farhanqaisarlink/farlink-netedge-/Hardware/Manufacturing Files/BOM/Network Analyzer.xlsx

Item | Reference | Qty | Value | Footprint | Manufacturer Part | Description | Note
1 | BOOT1 | 1 | Conn_01x02_Pin | Connector_PinHeader_2.54mm:PinHeader_1x02_P2.54mm_Vertical |  | Generic connector, single row, 01x02, script generated
2 | C1 | 1 | 100n/50V | Capacitor_SMD:C_0603_1608Metric |  | CAP CER 0.1UF 50V X7R 0603
3 | C2,C4,C5,C6 | 4 | 10uF/10V | Capacitor_SMD:C_0603_1608Metric |  | CAP CER 10UF 50V X5R 0805
4 | C3 | 1 | 100uF/10V | Capacitor_SMD:C_1210_3225Metric | GRM21BR61H106KE43L | CAP CER 10UF 50V X5R 0805
5 | C7,C9 | 2 | 10uf/10V | Capacitor_SMD:C_0603_1608Metric_Pad1.08x0.95mm_HandSolder
6 | C8 | 1 | 100nF/10V | Capacitor_SMD:C_0603_1608Metric_Pad1.08x0.95mm_HandSolder
7 | C10 | 1 | 10uF/10V | Capacitor_SMD:C_0603_1608Metric_Pad1.08x0.95mm_HandSolder |  | 10uF/16V
8 | C11 | 1 | 100nF/10V | Capacitor_SMD:C_0603_1608Metric
9 | CONSOLE1 | 1 | Conn_01x03_Pin | Connector_PinHeader_2.54mm:PinHeader_1x03_P2.54mm_Vertical |  | Generic connector, single row, 01x03, script generated
10 | D1,D2 | 2 | SMBJ5_0A_C83333 | JLCImport:SMBJ5_0A_C83333 | SMBJ5_0A_C83333 | -65℃~+150℃ 5V 6.4V 600W 65.3A 65.3uA 9.2V IEC 61000-4-2、IEC 61000-4-4 TVS Unidirectional DO-214AA ESD and Surge Protection (TVS/ESD) ROHS
11 | ETH1 | 1 | ARJM11D7-502-AB-EW2 | ARJM11D7-502-AB-EW2:ABRACON_ARJM11D7-502-AB-EW2 | ARJM11D7-502-AB-EW2 | 1 Port RJ45 Magjack Connector Through Hole 10/100/1000 Base-T, AutoMDIX
12 | LED_PWR1 | 1 | LTST-S270KGKT | JLCImport:LTST-S270KGKT | LTST-S270KGKT | -30℃~+85℃ 130° 20mA 2V 571nm 574nm 71mcd 75mW Discrete Diode Side View Mount Water Clear Yellow Green SMD,1.6x1.2mm LED Indication - Discrete ROHS
13 | LED_STATUS1 | 1 | LTST-S270KRKT | JLCImport:LTST-S270KRKT | LTST-S270KRKT | -30℃~+85℃ 130° 20mA 2V 571nm 574nm 71mcd 75mW Discrete Diode Side View Mount Water Clear Yellow Green SMD,1.6x1.2mm LED Indication - Discrete ROHS
14 | Module1 | 2 | ComputeModule5-CM5 | CM5IO:Raspberry-Pi-5-Compute-Module | DF40C-100DS-0.4V(51) | 100 Position Connector Receptacle, Center Strip Contacts Surface Mount Gold | Install 2 × DF40C-100DS-0.4V(51) connectors for CM5
15 | PWR_SW1 | 1 | PB400OAQR1BLK | PB400OAQR1BLK:SW_PB400OAQR1BLK | PB400EEQR1BLK | Pushbutton Switch DPST Standard Through Hole, Right Angle
16 | R1,R2 | 2 | 470 Ohm | Resistor_SMD:R_0603_1608Metric
17 | R3 | 1 | 15kOhm | Resistor_SMD:R_0603_1608Metric
18 | R4 | 1 | 2.2k | Resistor_SMD:R_0603_1608Metric_Pad0.98x0.95mm_HandSolder |  | Resistor, US symbol
19 | R5,R9 | 2 | 10k | Resistor_SMD:R_0603_1608Metric_Pad0.98x0.95mm_HandSolder |  | Resistor, US symbol
20 | R6 | 1 | 1k | Resistor_SMD:R_0603_1608Metric |  | Resistor, US symbol
21 | R7 | 1 | 100 | Resistor_SMD:R_0603_1608Metric |  | Resistor, US symbol
22 | R8,R13 | 2 | 10 | Resistor_SMD:R_0603_1608Metric |  | Resistor, US symbol
23 | R10,R12 | 2 | 10k | Resistor_SMD:R_0603_1608Metric |  | Resistor, US symbol
24 | R11 | 1 | 1kOhm | Resistor_SMD:R_0603_1608Metric |  | Resistor, US symbol
25 | SDCARD1 | 1 | 1040310811 | JLCImport:1040310811 | 1040310811 | -25℃~+85℃ 1.42mm Connector and Ejector MicroSD Card (TF Card) Push-Pull SMD SD Card / Memory Card Connector ROHS
26 | SW1 | 1 | 1825027-5 | JLCImport:1825027-5 | 1825027-5 | -20℃~+105℃ 1.24mm 1.6N 24V 3.5mm 50mA 7mm PC Pin Right Angle Round Button SPST 弯插,7x3.5mm Tactile Switches ROHS
27 | TEST_SW1 | 1 | B2B-PH-K-S_LF_SN | JLCImport:B2B-PH-K-S_LF_SN | B2B-PH-K-S(LF)(SN) | -25℃~+85℃ 1 100V 1x2P 2 2A 2P 2mm 4.5mm 5.9mm 6mm Brass K Pin PA66 PH Through Hole Tin UL94V-0 White 插件,P=2mm Wire To Board Connector ROHS
28 | U1,U2 | 2 | TPD4EUSB30 | Package_SON:USON-10_2.5x1.0mm_P0.5mm | TPD4EUSB30DQAR
29 | U3 | 1 | DS1021-2X13SF11-B | JLCImport:DS1021-2X13SF11-B | DS1021-2x13SF11-B | -40℃~+105℃ 2 2.54mm 2.54mm 250V 26P 2x13P 3A Black Copper alloy Gold Pin Header Through Hole Plugin,P=2.54mm Pin Headers ROHS
30 | U4 | 1 | AP22653W6-7 | Package_TO_SOT_SMD:SOT-23-6 | AP22653W6-7 | LOAD SWITCH,SOT26,T&R,3K
31 | U5 | 1 | TPS22998RYZR | JLCImport:TPS22998RYZR | TPS22998RYZR | -40℃~+105℃ 1 10A 200mV~5.5V 4mΩ Active High Load Switch Output discharge function、Soft-start、Over temperature protection WQFN-HR-10 Power Distribution Switches ROHS
32 | U6 | 1 | MY-1220-03-R | JLCImport:MY-1220-03-R | MY-1220-03-R | Battery buckle CR1220 Nickel plated Phosphor bronze - ROHS
33 | U7,U8 | 2 | 74LVC1G07GW_125 | 74LVC1G07GW_125:IC_74LVC1G07GW_125 | 74LVC1G07GW_125 | Buffer, Non-Inverting 1 Element 1 Bit per Element Open Drain Output 5-TSSOP
34 | U9 | 1 | RT9742GGJ5 | JLCImport:RT9742GGJ5 | RT9742GGJ5 | -40℃~+85℃ 1 1A 2.7V~6V 70mΩ Active High High Side Switch Short-Circuit Protection(SCP)、Undervoltage Protection(UVP)、Overcurrent Protection(OCP)、Over Temperature Protection TSOT-23-5 Power Distribution Switches ROHS
35 | U10,U11,U12 | 3 | USBLC6-2SC6 | USBLC6-2SC6:SOT95P280X145-6N | USBLC6-2SC6 | 17V Clamp 5A (8/20µs) Ipp Tvs Diode Surface Mount SOT-23-6
36 | USB1 | 1 | GSB4111312HR | JLCImport:GSB4111312HR | GSB4111312HR | 1 9P Blue Female Right Angle Type-A USB 3.1 插件 USB Connectors ROHS
37 | USB_BOOT1 | 1 | USB4120-03-C | JLCImport:USB4120-03-C | USB4120-03-C | -25℃~+85℃ 1 24P 48V 5A Black Female Type-C USB 2.0 SMD USB Connectors ROHS
38 | USB_POWER1 | 1 | USB4215-03-A_REVA | USB4215-03-A_REVA:GCT_USB4215-03-A_REVA | USB4215-03-A | USB-C (USB TYPE-C) USB 2.0 Receptacle Connector 24 (16+8 Dummy) Position Surface Mount, Right Angle; Through Hole
