farhanqaisarlink/farlink-netedge-/Hardware/PCBWAY/T-X52W642709A-2units-Network+Analyzer(2026-08-12).xls

PCBWay Bom Quotation, Product No.:T-X52W642709A
Item # | *Designator | *Qty | *Mfg Part # | Description / Value | *Package/Footprint | Your Instructions / Notes | *Unit Price(2 units) | *Total | *Delivery Time | *Actual Purchase Mfg Part # | *PCBWay Note | Customer Reply | PCBWay Update
1 | BOOT1 | 1 | Conn_01x02_Pin | Generic connector, single row, 01x02, script generated | Connector_PinHeader_2.54mm:PinHeader_1x02_P2.54mm_Vertical |  | $0.065 | $0.130 |  | PZ254V-11-02P | we will supply is PZ254V-11-02P ,OK?pls confirm
2 | C1 | 1 | 100n/50V | CAP CER 0.1UF 50V X7R 0603 | Capacitor_SMD:C_0603_1608Metric |  | $0.146 | $0.292 |  | CC0603KRX7R9BB104
3 | C2,C4,C5,C6 | 4 | 10uF/10V | CAP CER 10UF 50V X5R 0805 | Capacitor_SMD:C_0603_1608Metric |  | $0.116 | $0.928 |  | CL10A106KP8NNNC | Package should be 0603 or 0805？
4 | C3 | 1 | 100uF/10V | CAP CER 10UF 50V X5R 0805 | Capacitor_SMD:C_1210_3225Metric |  | $1.006 | $2.012 |  | GRM21BR61H106KE43L | The correct package for the listed Part Number [GRM21BR61H106KE43L] is indeed [0805], not [1210].Please confirm.
5 | C7,C9 | 2 | 10uf/10V |  | Capacitor_SMD:C_0603_1608Metric_Pad1.08x0.95mm_HandSolder |  | $0.194 | $0.776 |  | CL10A106KP8NNNC | The correct package for the listed Part Number [10uF/10V] is indeed [CP_EIA-3216-18_Kemet-A], not [0603].Please confirm.
6 | C8 | 1 | 100nF/10V |  | Capacitor_SMD:C_0603_1608Metric_Pad1.08x0.95mm_HandSolder |  | $0.652 | $1.304 |  | 0603ZD104KAT2A
7 | C10 | 1 | 10uF/10V | 10uF/16V | Capacitor_SMD:C_0603_1608Metric_Pad1.08x0.95mm_HandSolder |  | $0.387 | $0.774 |  | CL10A106KP8NNNC | The correct package for the listed Part Number [10uF/10V] is indeed [CP_EIA-3216-18_Kemet-A], not [0603],The correct voltage for the listed Part Number [10uF/10V] is indeed [10V], not [16V].Please confirm.
8 | C11 | 1 | 100nF/10V |  | Capacitor_SMD:C_0603_1608Metric |  | $0.652 | $1.304 |  | 0603ZD104KAT2A
9 | CONSOLE1 | 1 | Conn_01x03_Pin | Generic connector, single row, 01x03, script generated | Connector_PinHeader_2.54mm:PinHeader_1x03_P2.54mm_Vertical |  | $0.075 | $0.150 |  | PZ254V-11-03P | we will supply is PZ254V-11-03P,OK?pls confirm
10 | D1,D2 | 2 | SMBJ5_0A_C83333 | -65℃~+150℃ 5V 6.4V 600W 65.3A 65.3uA 9.2V IEC 61000-4-2、IEC 61000-4-4 TVS Unidirectional DO-214AA ESD and Surge Protection (TVS/ESD) ROHS | JLCImport:SMBJ5_0A_C83333 |  | $0.165 | $0.660 |  | SMBJ5.0A
11 | ETH1 | 1 | ARJM11D7-502-AB-EW2 | 1 Port RJ45 Magjack Connector Through Hole 10/100/1000 Base-T, AutoMDIX | ARJM11D7-502-AB-EW2:ABRACON_ARJM11D7-502-AB-EW2 |  | $7.369 | $14.738 |  | ARJM11D7-502-AB-EW2
12 | LED_PWR1 | 1 | LTST-S270KGKT | -30℃~+85℃ 130° 20mA 2V 571nm 574nm 71mcd 75mW Discrete Diode Side View Mount Water Clear Yellow Green SMD,1.6x1.2mm LED Indication - Discrete ROHS | JLCImport:LTST-S270KGKT |  | $0.077 | $0.154 |  | LTST-S270KGKT
13 | LED_STATUS1 | 1 | LTST-S270KRKT | -30℃~+85℃ 130° 20mA 2V 571nm 574nm 71mcd 75mW Discrete Diode Side View Mount Water Clear Yellow Green SMD,1.6x1.2mm LED Indication - Discrete ROHS | JLCImport:LTST-S270KRKT |  | $0.099 | $0.198 |  | LTST-S270KRKT
14 | Module1 | 2 | ComputeModule5-CM5 | 100 Position Connector Receptacle, Center Strip Contacts Surface Mount Gold | CM5IO:Raspberry-Pi-5-Compute-Module | Install 2 × DF40C-100DS-0.4V(51) connectors for CM5 | $1.610 | $6.440 |  | DF40C-100DS-0.4V(51)
15 | PWR_SW1 | 1 | PB400OAQR1BLK | PUSHBUTTON, 3A, 30VDC DPST, Off-(On), Through Hole, Right Angle | PB400OAQR1BLK:SW_PB400OAQR1BLK |  | $3.463 | $6.926 |  | PB400OAQR1BLK
16 | R1,R2 | 2 | 470 Ohm |  | Resistor_SMD:R_0603_1608Metric |  | $0.024 | $0.096 |  | 0603WAF4700T5E
17 | R3 | 1 | 15kOhm |  | Resistor_SMD:R_0603_1608Metric |  | $0.063 | $0.126 |  | 0603WAF1502T5E
18 | R4 | 1 | 2.2k | Resistor, US symbol | Resistor_SMD:R_0603_1608Metric_Pad0.98x0.95mm_HandSolder |  | $0.040 | $0.080 |  | 0603WAF2201T5E
19 | R5,R9 | 2 | 10k | Resistor, US symbol | Resistor_SMD:R_0603_1608Metric_Pad0.98x0.95mm_HandSolder |  | $0.030 | $0.120 |  | NQ03WAF1002T5E
20 | R6 | 1 | 1k | Resistor, US symbol | Resistor_SMD:R_0603_1608Metric |  | $0.099 | $0.198 |  | RC0603FR-071KL
21 | R7 | 1 | 100 | Resistor, US symbol | Resistor_SMD:R_0603_1608Metric |  | $0.029 | $0.058 |  | 0603WAF1000T5E
22 | R8,R13 | 2 | 10 | Resistor, US symbol | Resistor_SMD:R_0603_1608Metric |  | $0.072 | $0.288 |  | AC0603FR-0710RL
23 | R10,R12 | 2 | 10k | Resistor, US symbol | Resistor_SMD:R_0603_1608Metric |  | $0.030 | $0.120 |  | NQ03WAF1002T5E
24 | R11 | 1 | 1kOhm | Resistor, US symbol | Resistor_SMD:R_0603_1608Metric |  | $0.099 | $0.198 |  | RC0603FR-071KL
25 | SDCARD1 | 1 | 1040310811 | -25℃~+85℃ 1.42mm Connector and Ejector MicroSD Card (TF Card) Push-Pull SMD SD Card / Memory Card Connector ROHS | JLCImport:1040310811 |  | $0.604 | $1.208 |  | 1040310811
26 | SW1 | 1 | 1825027-5 | -20℃~+105℃ 1.24mm 1.6N 24V 3.5mm 50mA 7mm PC Pin Right Angle Round Button SPST 弯插,7x3.5mm Tactile Switches ROHS | JLCImport:1825027-5 |  | $0.391 | $0.782 |  | 1825027-5
27 | TEST_SW1 | 1 | B2B-PH-K-S_LF_SN | -25℃~+85℃ 1 100V 1x2P 2 2A 2P 2mm 4.5mm 5.9mm 6mm Brass K Pin PA66 PH Through Hole Tin UL94V-0 White 插件,P=2mm Wire To Board Connector ROHS | JLCImport:B2B-PH-K-S_LF_SN |  | $0.458 | $0.916 |  | B2B-PH-K-S(LF)(SN)
28 | U1,U2 | 2 | TPD4EUSB30 |  | Package_SON:USON-10_2.5x1.0mm_P0.5mm |  | $0.528 | $2.112 |  | TPD4EUSB30DQAR | 品牌 TI(德州仪器) 封装 USON-10(1x2.5)
29 | U3 | 1 | DS1021-2X13SF11-B | -40℃~+105℃ 2 2.54mm 2.54mm 250V 26P 2x13P 3A Black Copper alloy Gold Pin Header Through Hole Plugin,P=2.54mm Pin Headers ROHS | JLCImport:DS1021-2X13SF11-B |  | $0.465 | $0.930 |  | DS1021-2x13SF11-B
30 | U4 | 1 | AP22653W6-7 | LOAD SWITCH,SOT26,T&R,3K | Package_TO_SOT_SMD:SOT-23-6 |  | $0.192 | $0.384 |  | AP22653W6-7
31 | U5 | 1 | TPS22998RYZR | -40℃~+105℃ 1 10A 200mV~5.5V 4mΩ Active High Load Switch Output discharge function、Soft-start、Over temperature protection WQFN-HR-10 Power Distribution Switches ROHS | JLCImport:TPS22998RYZR |  | $0.535 | $1.070 |  | TPS22998RYZR
32 | U6 | 1 | MY-1220-03-R | Battery buckle CR1220 Nickel plated Phosphor bronze - ROHS | JLCImport:MY-1220-03-R |  | $0.871 | $1.742 |  | MY-1220-03-R
33 | U7,U8 | 2 | 74LVC1G07GW_125 | Buffer, Non-Inverting 1 Element 1 Bit per Element Open Drain Output 5-TSSOP | 74LVC1G07GW_125:IC_74LVC1G07GW_125 |  | $0.187 | $0.748 |  | 74LVC1G07GW,125
34 | U9 | 1 | RT9742GGJ5 | -40℃~+85℃ 1 1A 2.7V~6V 70mΩ Active High High Side Switch Short-Circuit Protection(SCP)、Undervoltage Protection(UVP)、Overcurrent Protection(OCP)、Over Temperature Protection TSOT-23-5 Power Distribution Switches ROHS | JLCImport:RT9742GGJ5 |  | $0.108 | $0.216 |  | RT9742GGJ5
35 | U10,U11,U12 | 3 | USBLC6-2SC6 | 17V Clamp 5A (8/20µs) Ipp Tvs Diode Surface Mount SOT-23-6 | USBLC6-2SC6:SOT95P280X145-6N |  | $0.395 | $2.370 |  |  | ST(意法半导体) SOT-23-6L
36 | USB1 | 1 | GSB4111312HR | 1 9P Blue Female Right Angle Type-A USB 3.1 插件 USB Connectors ROHS | JLCImport:GSB4111312HR |  | $1.667 | $3.334 |  | GSB4111312HR
37 | USB_BOOT1 | 1 | USB4120-03-C | -25℃~+85℃ 1 24P 48V 5A Black Female Type-C USB 2.0 SMD USB Connectors ROHS | JLCImport:USB4120-03-C |  | $1.071 | $2.142 |  | USB4120-03-C
38 | USB_POWER1 | 1 | USB4215-03-A_REVA | USB-C (USB TYPE-C) USB 2.0 Receptacle Connector 24 (16+8 Dummy) Position Surface Mount, Right Angle; Through Hole | USB4215-03-A_REVA:GCT_USB4215-03-A_REVA |  | $0.828 | $1.656 | 7-10 Workdays | USB4215-03-A
 |  |  |  |  |  |  | Component Cost | $57.68
 |  |  |  |  |  |  | Assembly Cost
 |  |  |  |  |  |  | PCB Cost
 |  |  |  |  |  |  | V3 Member 3% off | $0.00
 |  |  |  |  |  |  | All Total 2 Units | $57.68
