farhanqaisarlink/farlink-netedge-/(list of files, cad)

Other CAD files:
Hardware/3D/with LCD.step
Hardware/3D/without LCD.step
