farhanqaisarlink/farlink-netedge-/Hardware/PDF/Network Analyzer.pdf

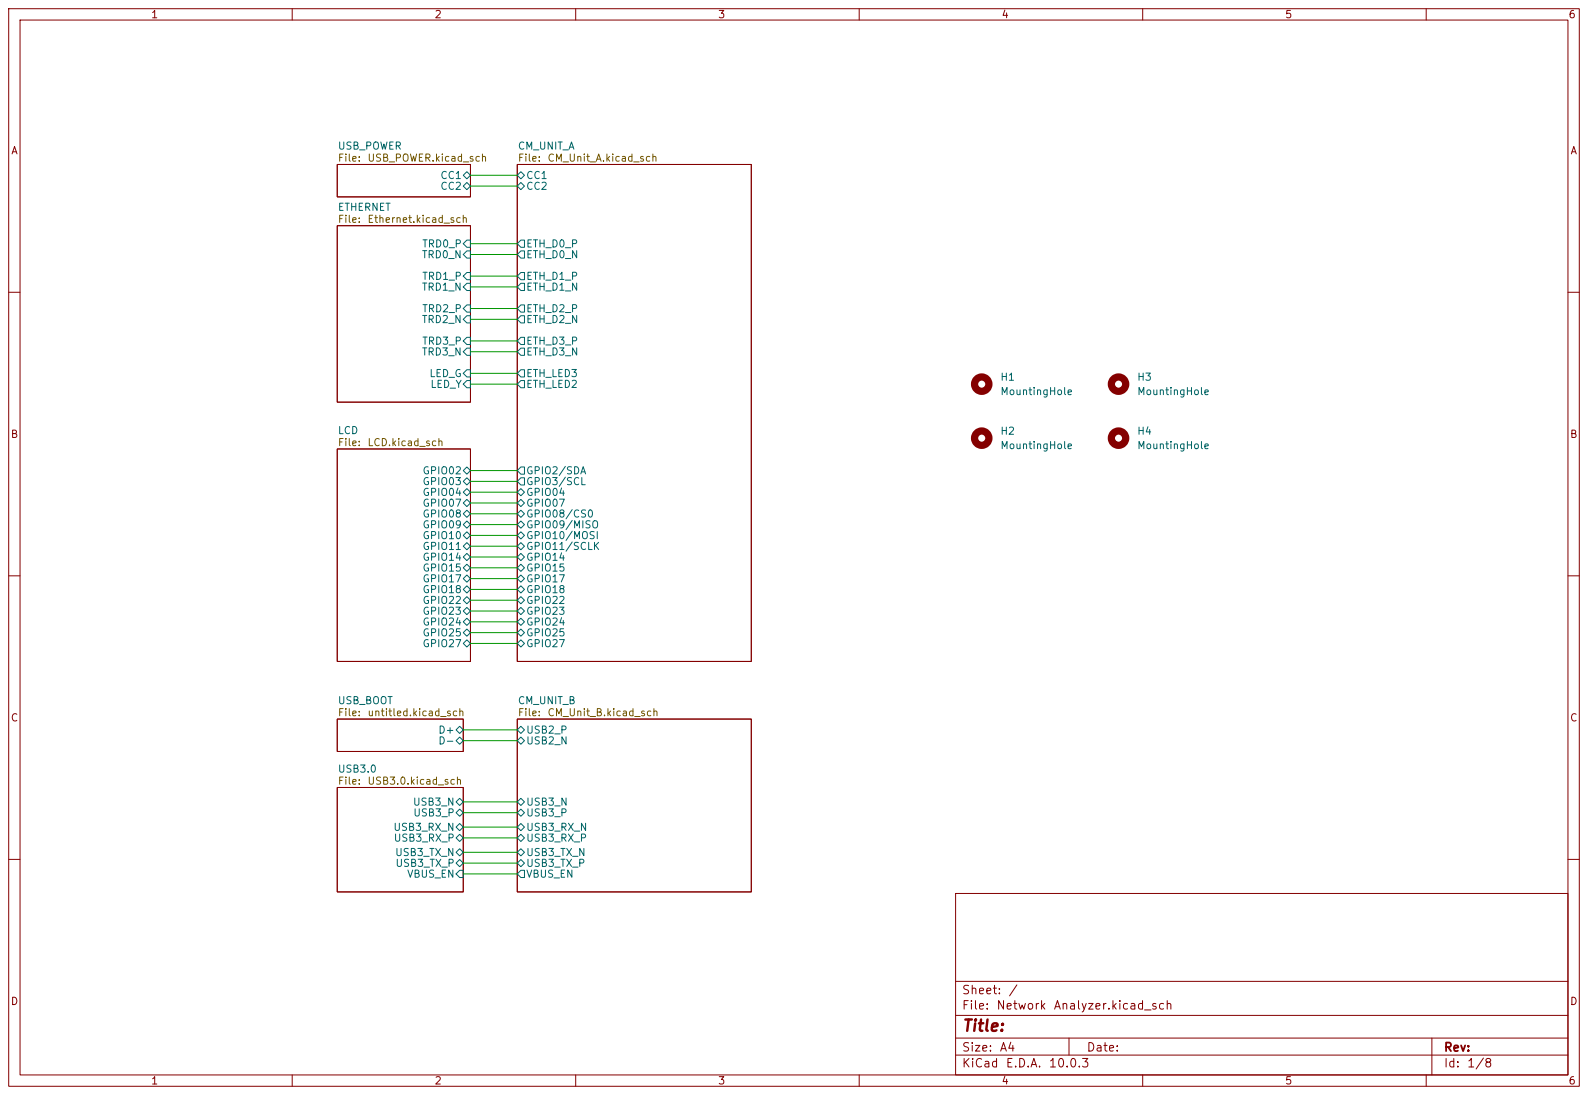
[picture p1: page 1]

Size: A4 | Rev:
KiCad E.D.A. 10.0.3 | Id: 1/8

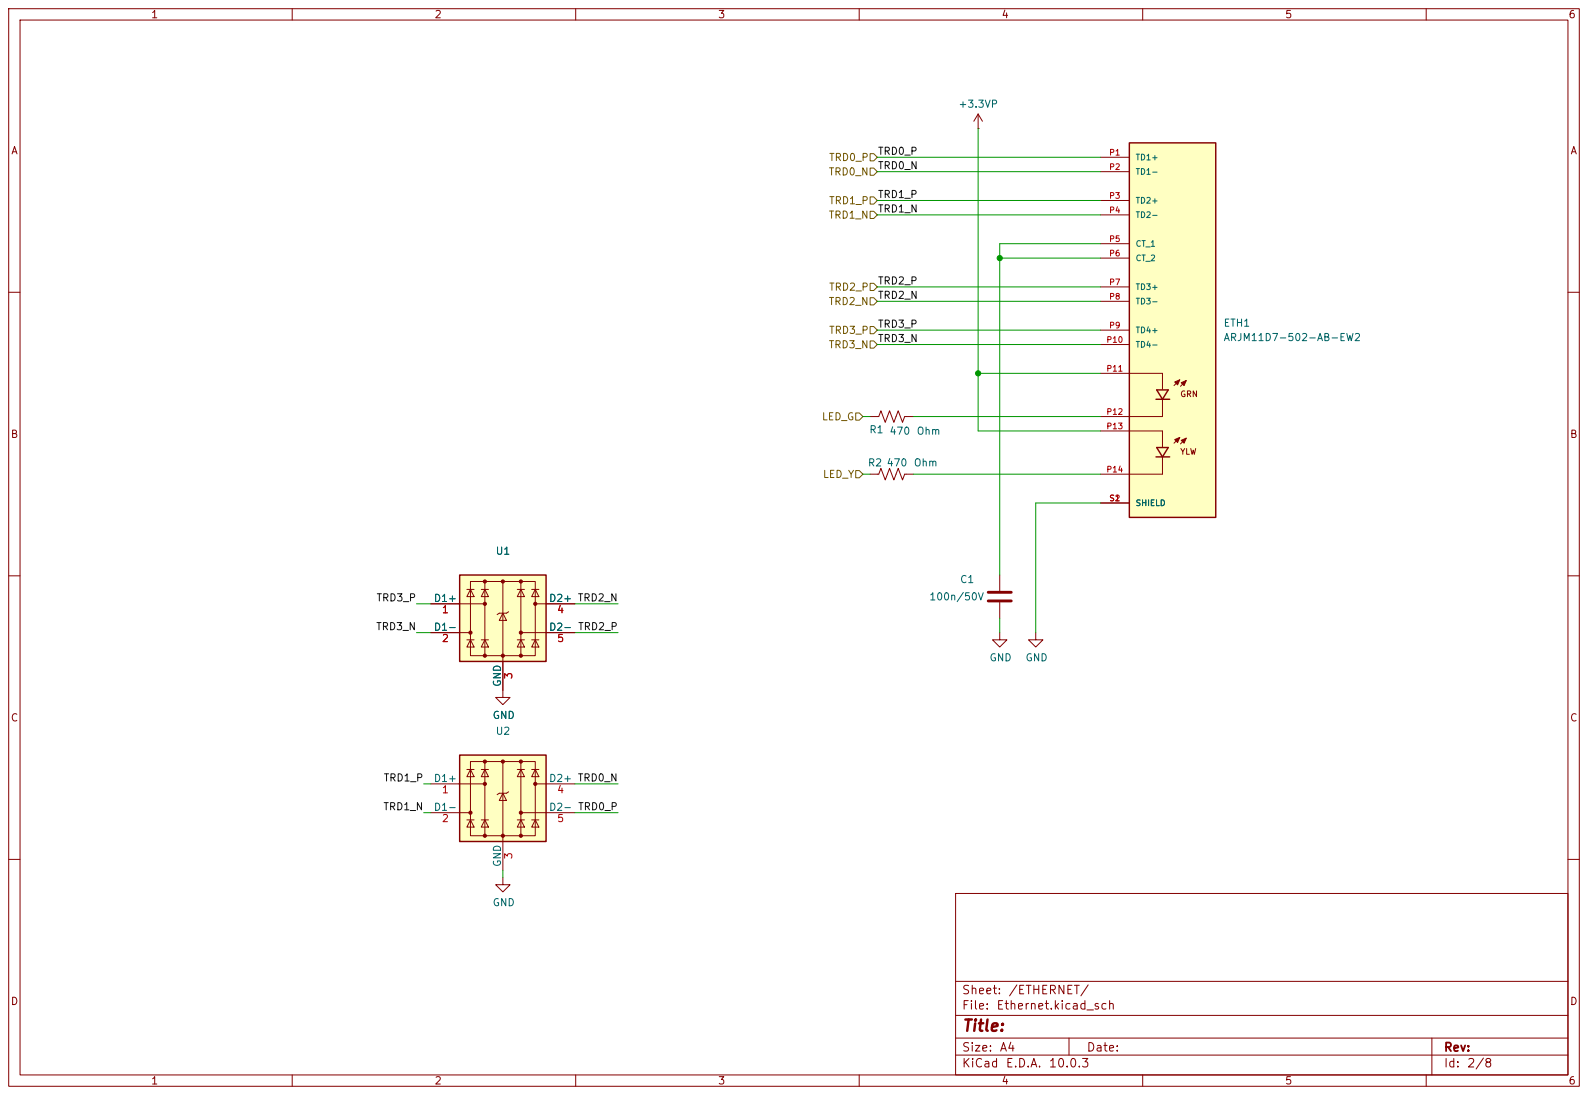
[picture p2: page 2]

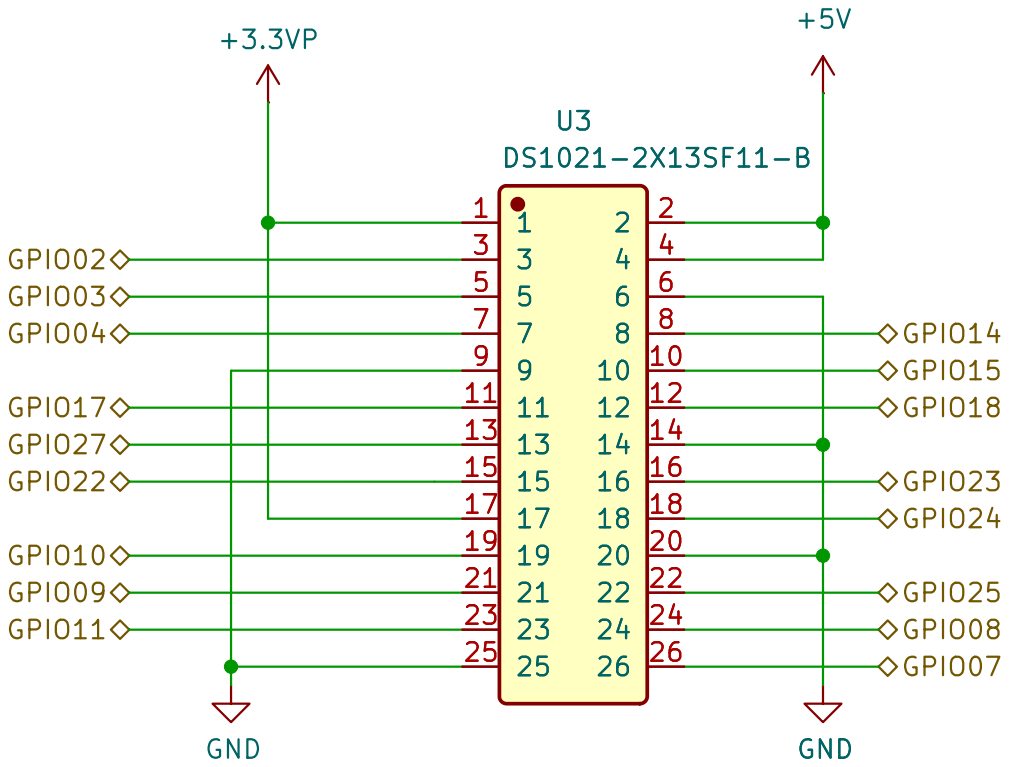
[picture p3: page 3]

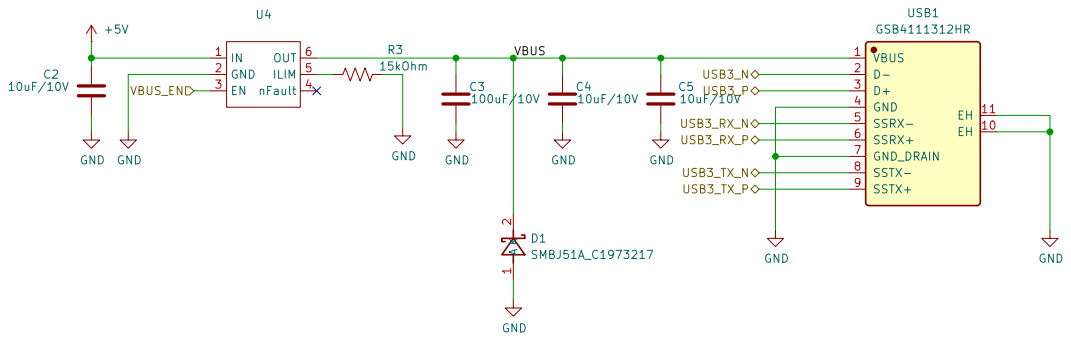
[picture p4: page 4]

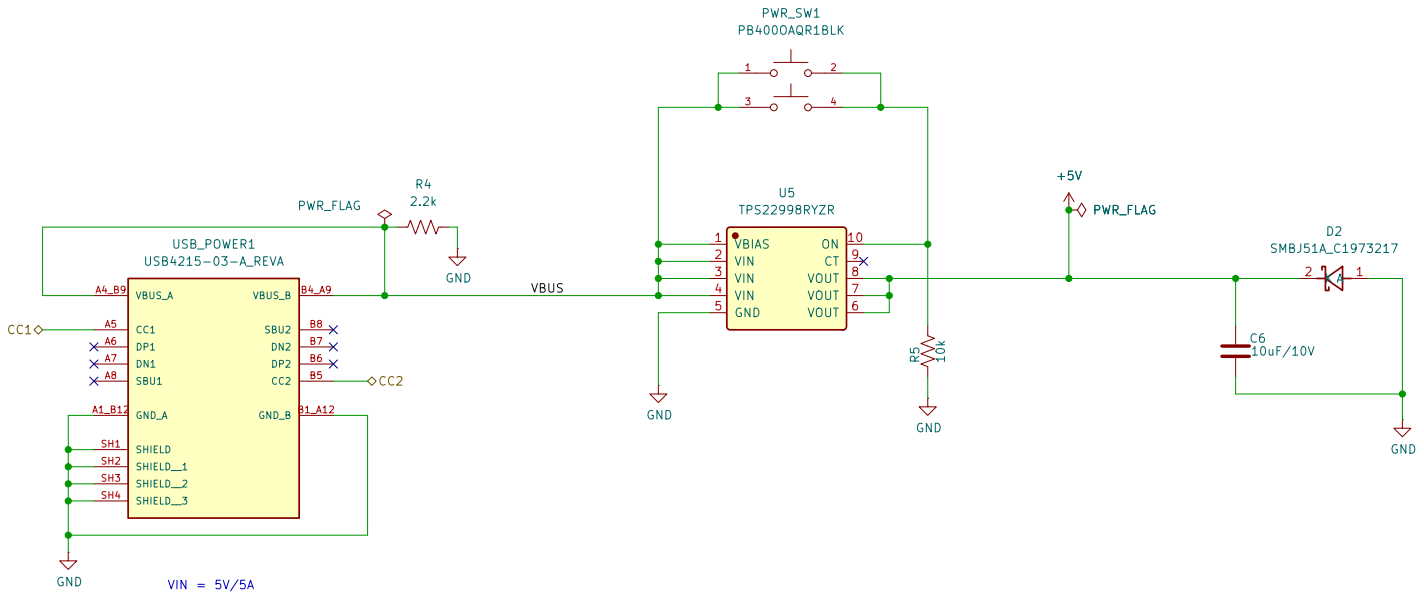
[picture p5: page 5]

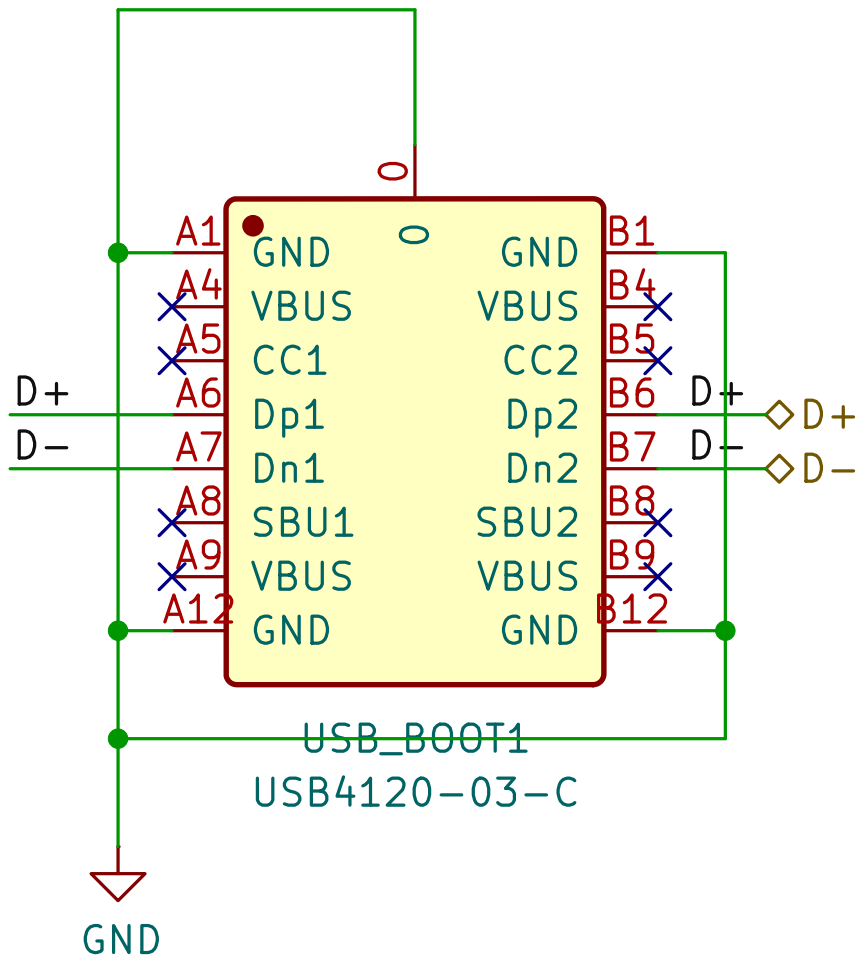
[picture p6: page 6]

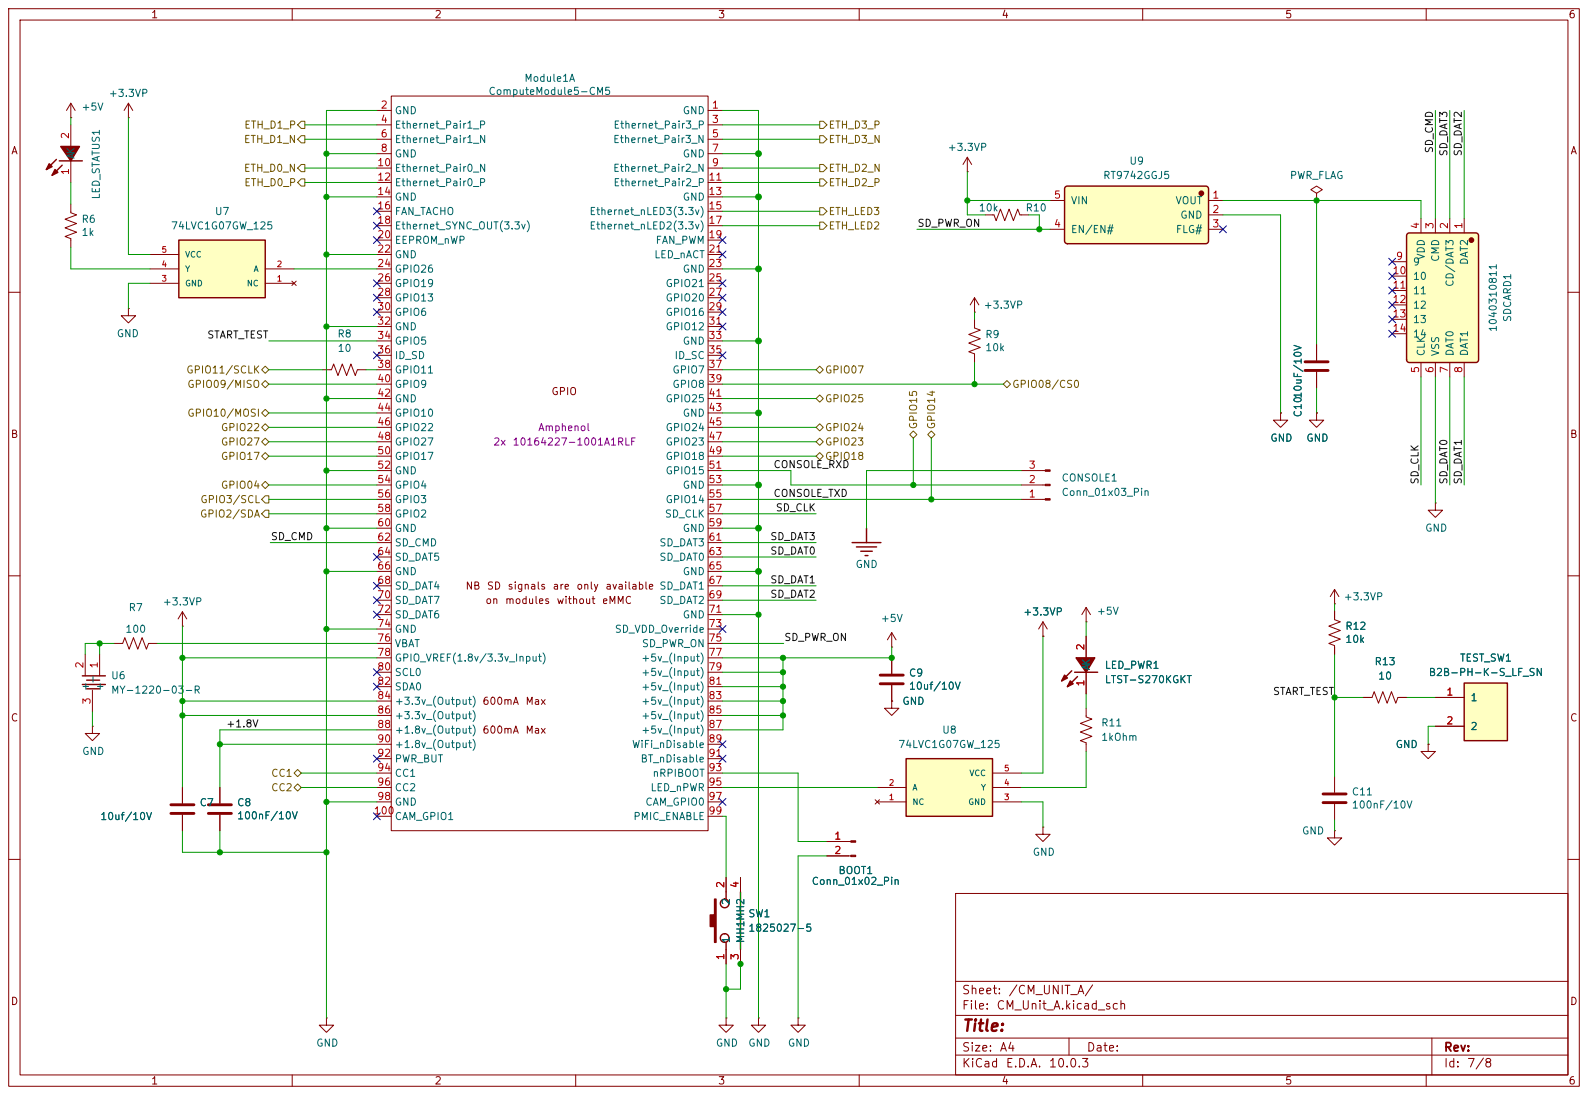
[picture p7: page 7]

600mA Max 600mA Max NB SD signals are only available on modules without eMMC

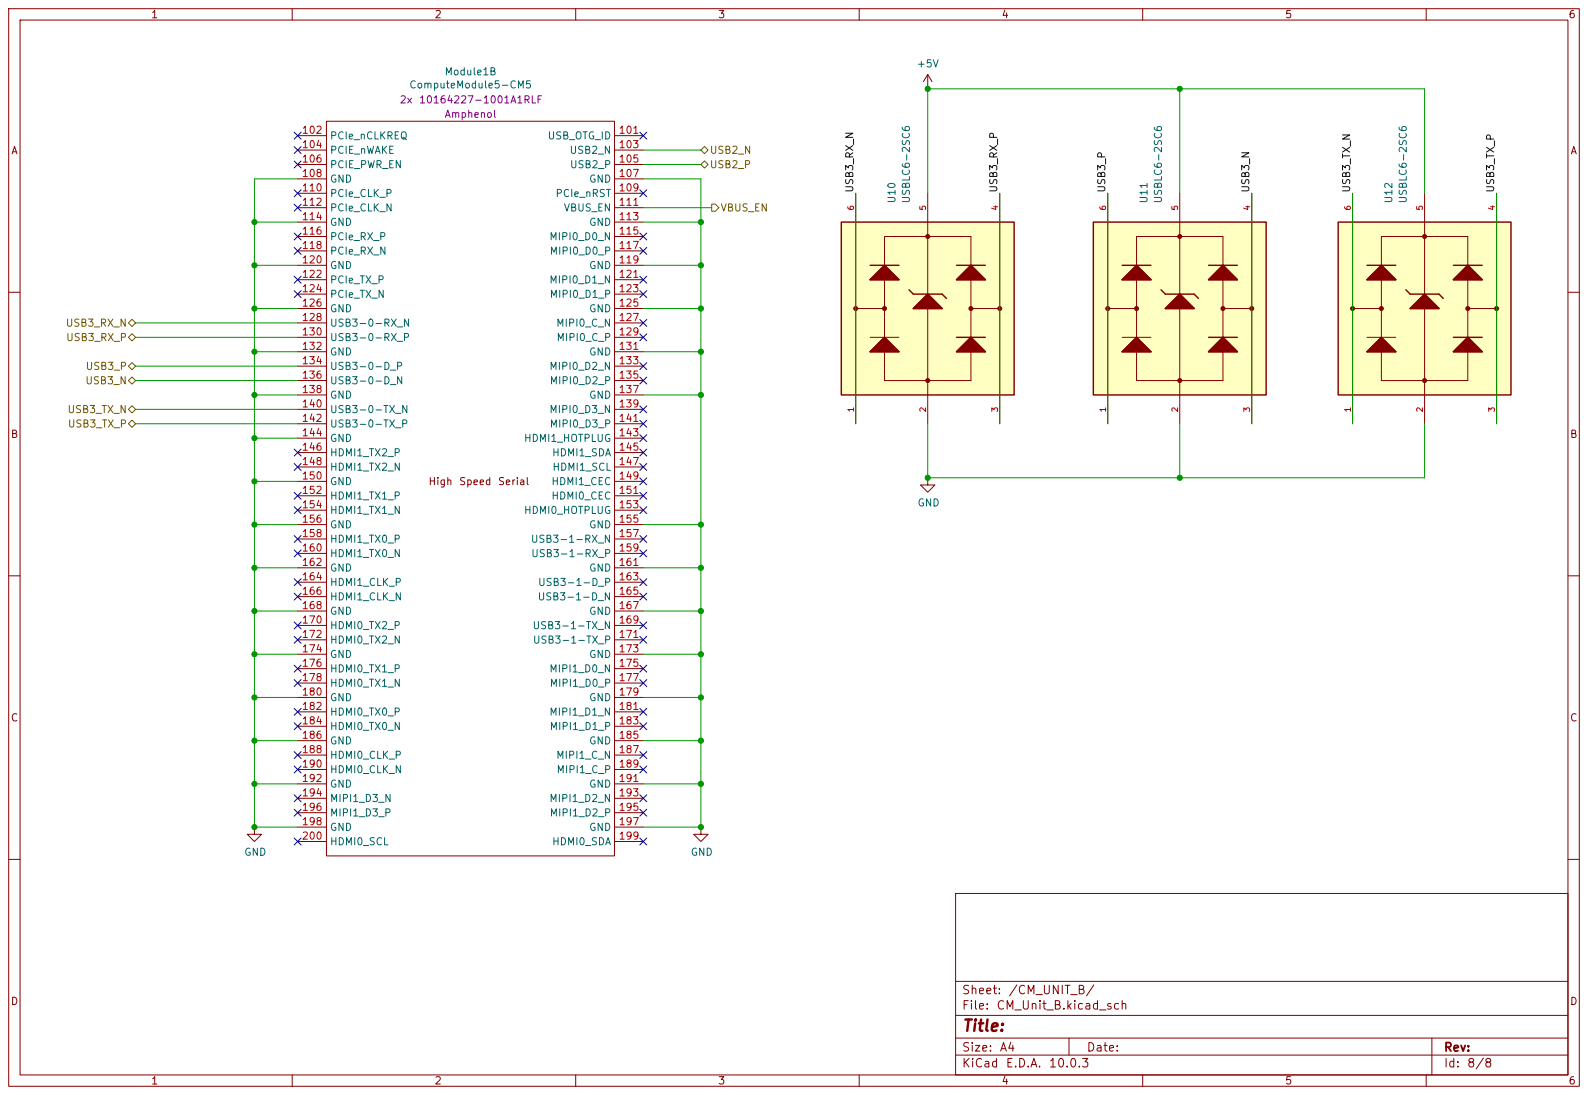
[picture p8: page 8]
