farhanqaisarlink/farlink-netedge-/Hardware/Network Analyzer.kicad_pcb

## KiCad design Hardware/Network Analyzer.kicad_pcb (2026-10-11)

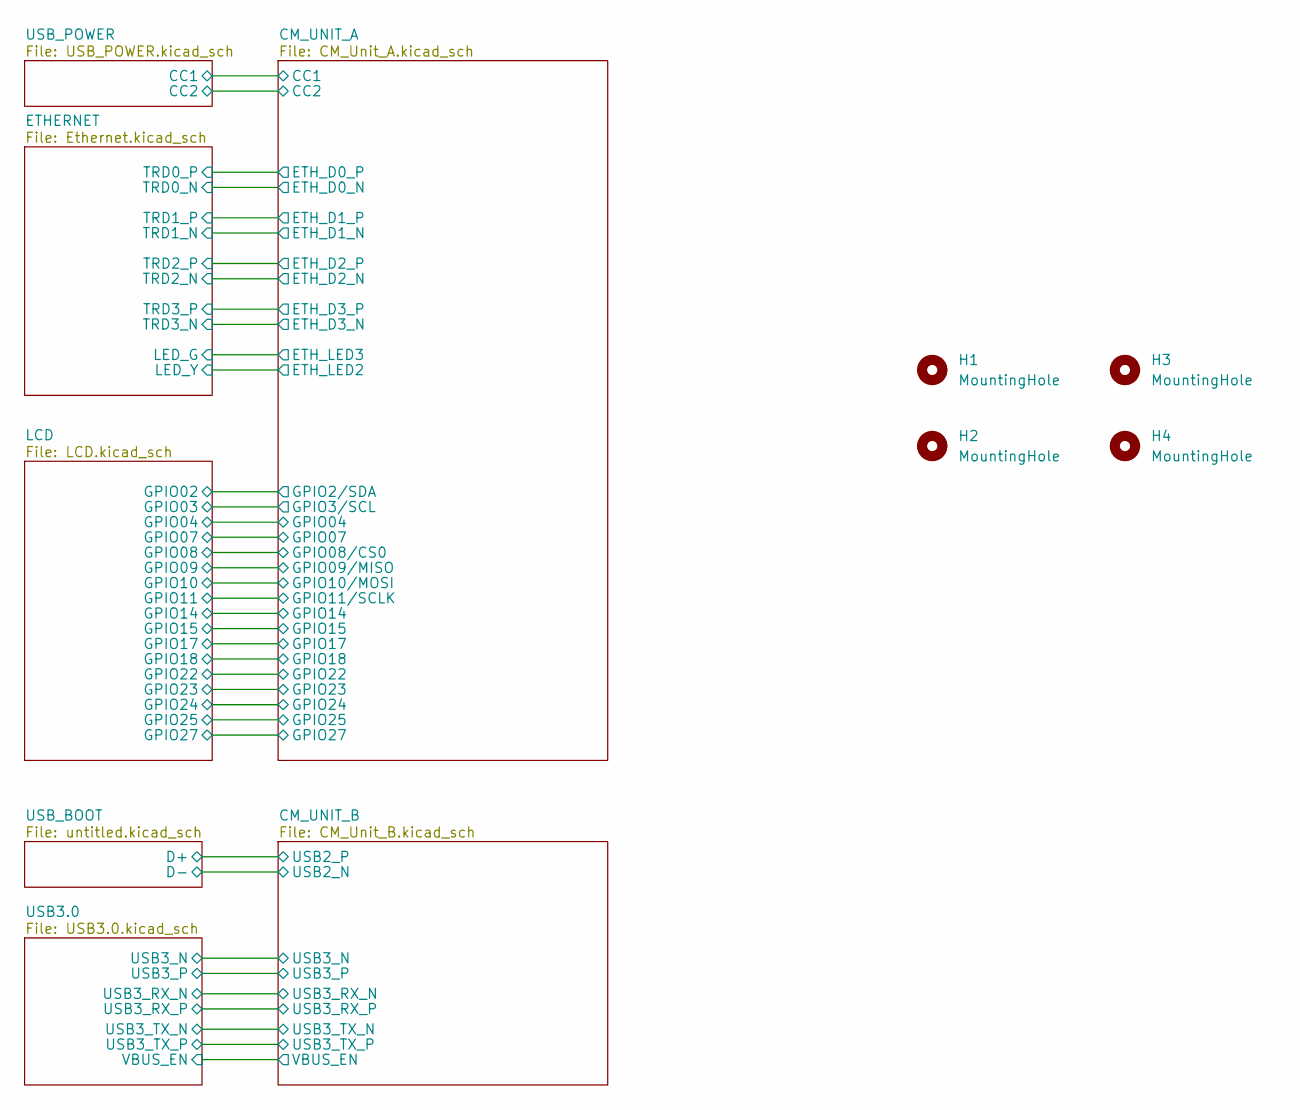
[picture p9: schematic Network Analyzer.kicad_sch]

Parts:
H1, H2, H3, H4: MountingHole; MountingHole_3.2mm_M3

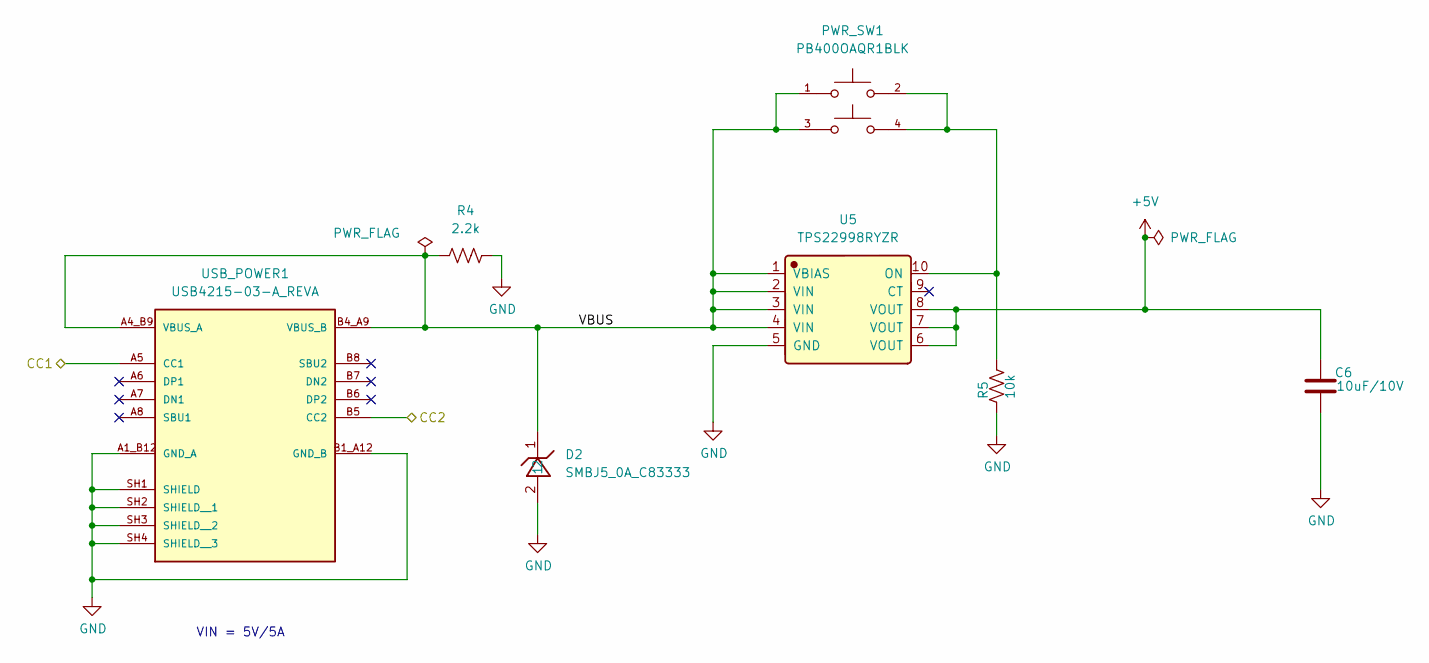
[picture p10: schematic USB_POWER.kicad_sch]

Parts:
C6: 10uF/10V; C_0603_1608Metric; Manufacturer_Part_Number GRM21BR61H106KE43L
D2: SMBJ5_0A_C83333; Manufacturer Part SMBJ5.0A; LCSC C83333
PWR_SW1: PB400OAQR1BLK; SW_PB400OAQR1BLK; PARTREV A
R4: 2.2k; R_0603_1608Metric_Pad0.98x0.95mm_HandSolder
R5: 10k; R_0603_1608Metric_Pad0.98x0.95mm_HandSolder; Part Description Resistor 1K M1005 1% 63mW
U5: TPS22998RYZR; Manufacturer Part TPS22998RYZR; LCSC C5220080
USB_POWER1: USB4215-03-A_REVA; GCT_USB4215-03-A_REVA; MPN USB4215-03-A

Connections:
+5V: C6.1, U5.6 (VOUT), U5.7 (VOUT), U5.8 (VOUT); also elsewhere on the board
/CM_UNIT_A/CC1: USB_POWER1.A5 (CC1); also elsewhere on the board
/CM_UNIT_A/CC2: USB_POWER1.B5 (CC2); also elsewhere on the board
/USB_POWER/VBUS: D2.1, PWR_SW1.1, PWR_SW1.3, R4.1, U5.1 (VBIAS), U5.2 (VIN), U5.3 (VIN), U5.4 (VIN), USB_POWER1.A4_B9 (VBUS_A), USB_POWER1.B4_A9 (VBUS_B)
GND: C6.2, D2.2, R4.2, R5.2, U5.5 (GND), USB_POWER1.A1_B12 (GND_A), USB_POWER1.B1_A12 (GND_B), USB_POWER1.SH1 (SHIELD), USB_POWER1.SH2 (SHIELD__1), USB_POWER1.SH3 (SHIELD__2), USB_POWER1.SH4 (SHIELD__3); also elsewhere on the board
unnamed: PWR_SW1.2, PWR_SW1.4, R5.1, U5.10 (ON)

Notes on the sheet:
VIN = 5V/5A

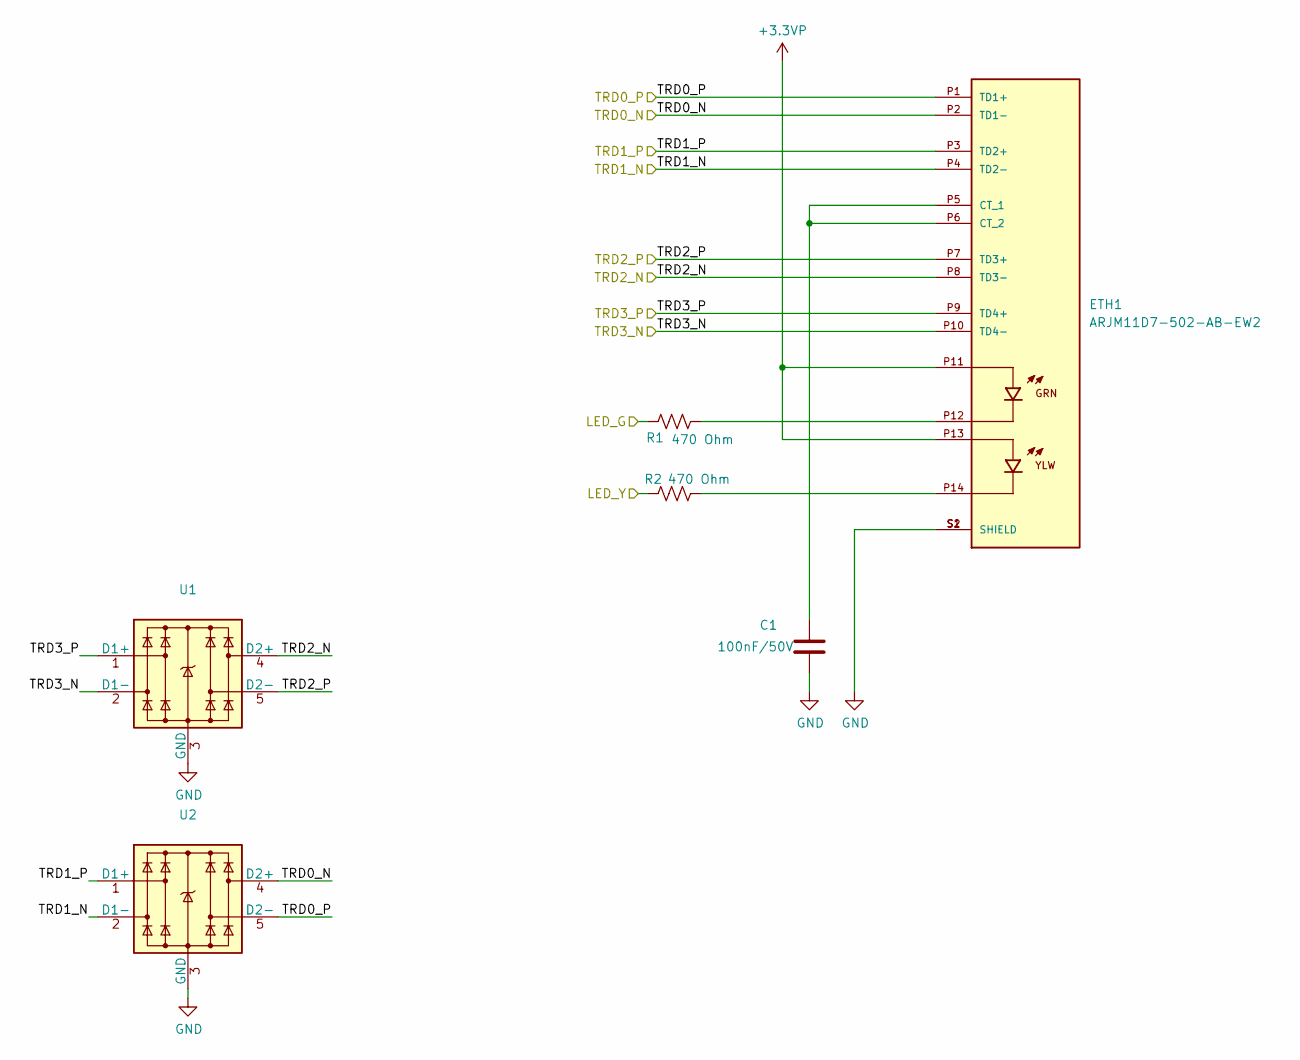
[picture p11: schematic Ethernet.kicad_sch]

Parts:
C1: 100nF/50V; C_0603_1608Metric; Manufacturer_Part_Number CL10B104KB8NNNC
ETH1: ARJM11D7-502-AB-EW2; ABRACON_ARJM11D7-502-AB-EW2; PARTREV 01-21-20
R1, R2: 470 Ohm; R_0603_1608Metric
U1, U2: TPD4EUSB30; USON-10_2.5x1.0mm_P0.5mm; Part Description Quad TVS diode for high speed signals (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

Connections:
+3.3VP: ETH1.P11, ETH1.P13; also elsewhere on the board
/CM_UNIT_A/ETH_LED2: R2.1; also elsewhere on the board
/CM_UNIT_A/ETH_LED3: R1.1; also elsewhere on the board
/ETHERNET/TRD0_N: ETH1.P2 (TD1-), U2.4 (D2+), U2.7; also elsewhere on the board
/ETHERNET/TRD0_P: ETH1.P1 (TD1+), U2.5 (D2-), U2.6; also elsewhere on the board
/ETHERNET/TRD1_N: ETH1.P4 (TD2-), U2.2 (D1-), U2.9; also elsewhere on the board
/ETHERNET/TRD1_P: ETH1.P3 (TD2+), U2.1 (D1+), U2.10; also elsewhere on the board
/ETHERNET/TRD2_N: ETH1.P8 (TD3-), U1.4 (D2+), U1.7; also elsewhere on the board
/ETHERNET/TRD2_P: ETH1.P7 (TD3+), U1.5 (D2-), U1.6; also elsewhere on the board
/ETHERNET/TRD3_N: ETH1.P10 (TD4-), U1.2 (D1-), U1.9; also elsewhere on the board
/ETHERNET/TRD3_P: ETH1.P9 (TD4+), U1.1 (D1+), U1.10; also elsewhere on the board
GND: C1.2, ETH1.S1 (SHIELD), ETH1.S2 (SHIELD), U1.3 (GND), U1.8 (GND), U2.3 (GND), U2.8 (GND); also elsewhere on the board
unnamed: C1.1, ETH1.P5 (CT_1), ETH1.P6 (CT_2)
unnamed: ETH1.P12, R1.2
unnamed: ETH1.P14, R2.2

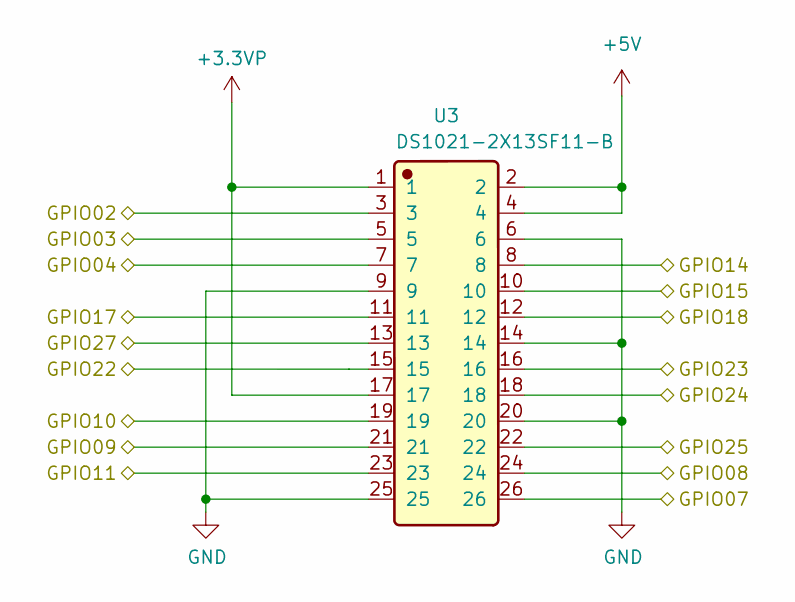
[picture p12: schematic LCD.kicad_sch]

Parts:
U3: DS1021-2X13SF11-B; Manufacturer Part DS1021-2x13SF11-B; LCSC C7430409

Connections:
+3.3VP: U3.1, U3.17; also elsewhere on the board
+5V: U3.2, U3.4; also elsewhere on the board
/CM_UNIT_A/CONSOLE_RXD: U3.10; also elsewhere on the board
/CM_UNIT_A/CONSOLE_TXD: U3.8; also elsewhere on the board
/CM_UNIT_A/GPIO2/SDA: U3.3; also elsewhere on the board
/CM_UNIT_A/GPIO3/SCL: U3.5; also elsewhere on the board
/CM_UNIT_A/GPIO04: U3.7; also elsewhere on the board
/CM_UNIT_A/GPIO07: U3.26; also elsewhere on the board
/CM_UNIT_A/GPIO08/CS0: U3.24; also elsewhere on the board
/CM_UNIT_A/GPIO09/MISO: U3.21; also elsewhere on the board
/CM_UNIT_A/GPIO10/MOSI: U3.19; also elsewhere on the board
/CM_UNIT_A/GPIO11/SCLK: U3.23; also elsewhere on the board
/CM_UNIT_A/GPIO17: U3.11; also elsewhere on the board
/CM_UNIT_A/GPIO18: U3.12; also elsewhere on the board
/CM_UNIT_A/GPIO22: U3.15; also elsewhere on the board
/CM_UNIT_A/GPIO23: U3.16; also elsewhere on the board
/CM_UNIT_A/GPIO24: U3.18; also elsewhere on the board
/CM_UNIT_A/GPIO25: U3.22; also elsewhere on the board
/CM_UNIT_A/GPIO27: U3.13; also elsewhere on the board
GND: U3.6, U3.9, U3.14, U3.20, U3.25; also elsewhere on the board

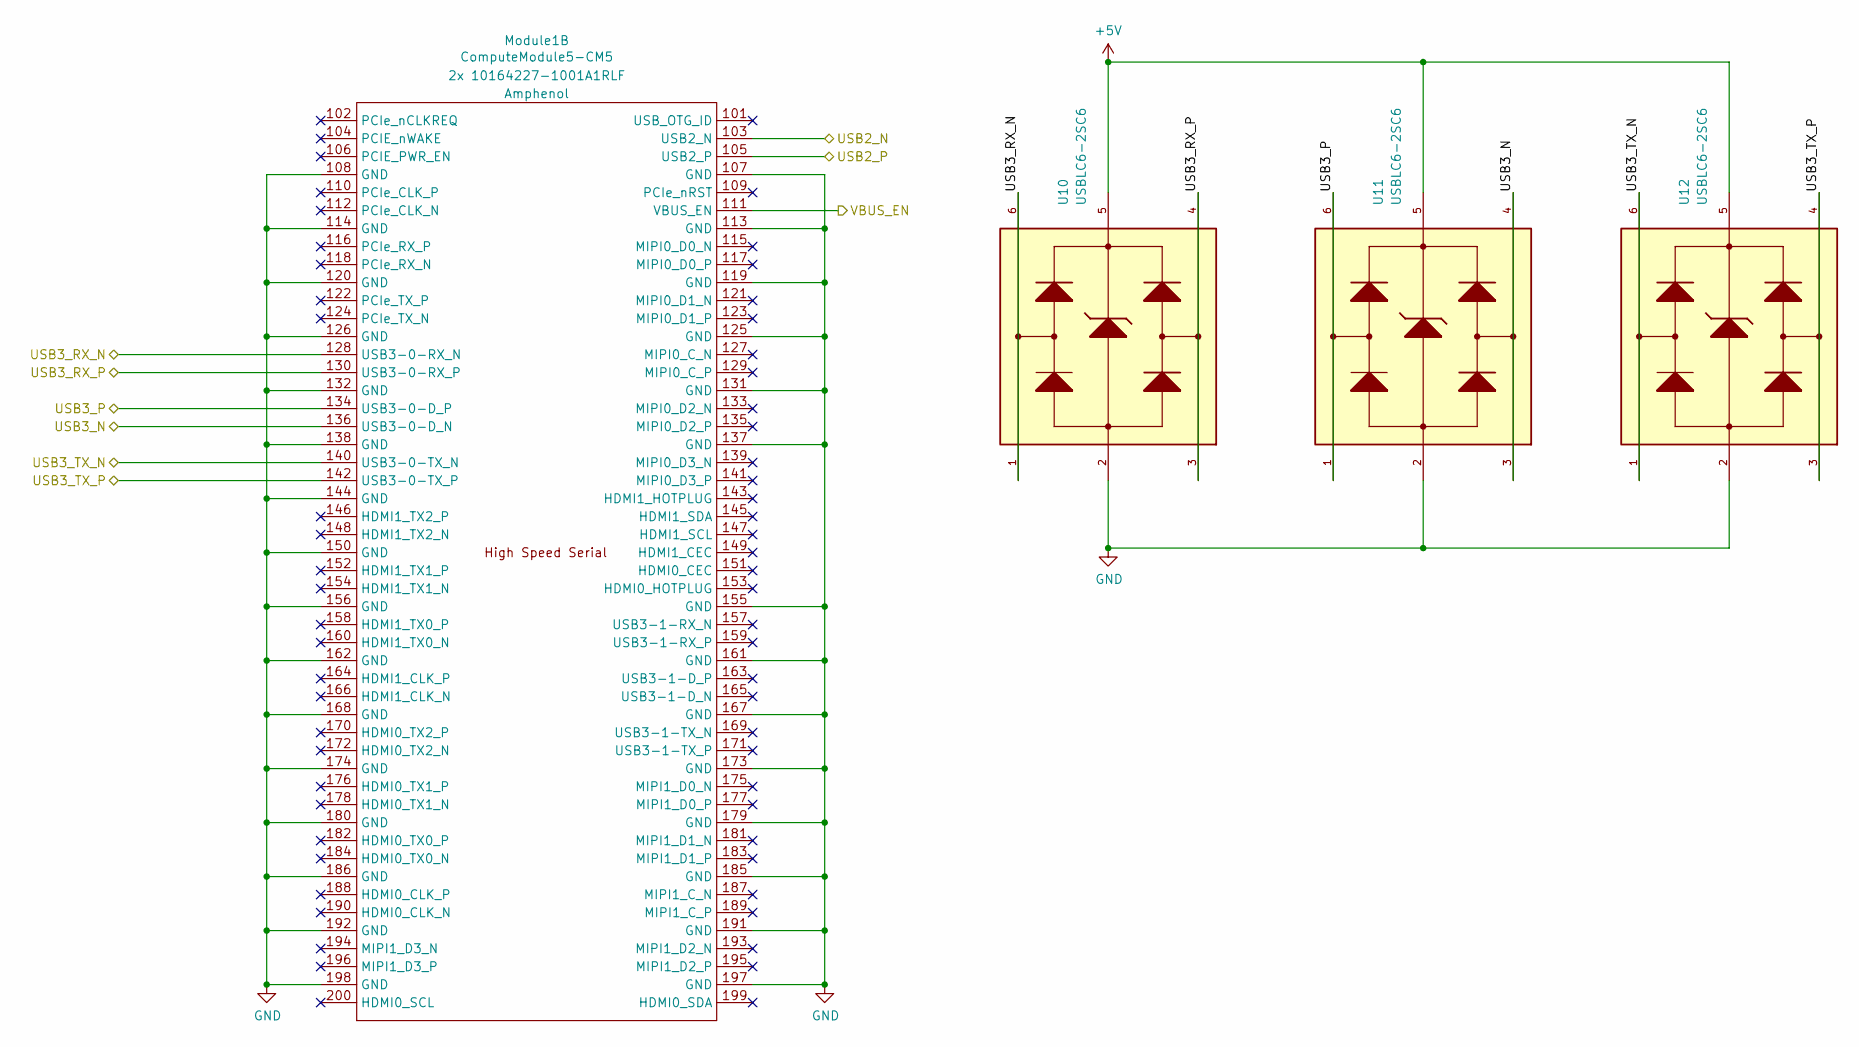
[picture p13: schematic CM_Unit_B.kicad_sch]

Parts:
Module1: ComputeModule5-CM5; Raspberry-Pi-5-Compute-Module; Part Description 100 Position Connector Receptacle, Cent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
U10, U11, U12: USBLC6-2SC6; SOT95P280X145-6N; Manufacturer Part USBLC6-2SC6

Connections:
+5V: U10.5, U11.5, U12.5; also elsewhere on the board
/CM_UNIT_B/USB3_N: Module1.136 (USB3-0-D_N), U11.3, U11.4; also elsewhere on the board
/CM_UNIT_B/USB3_P: Module1.134 (USB3-0-D_P), U11.1, U11.6; also elsewhere on the board
/CM_UNIT_B/USB3_RX_N: Module1.128 (USB3-0-RX_N), U10.1, U10.6; also elsewhere on the board
/CM_UNIT_B/USB3_RX_P: Module1.130 (USB3-0-RX_P), U10.3, U10.4; also elsewhere on the board
/CM_UNIT_B/USB3_TX_N: Module1.140 (USB3-0-TX_N), U12.1, U12.6; also elsewhere on the board
/CM_UNIT_B/USB3_TX_P: Module1.142 (USB3-0-TX_P), U12.3, U12.4; also elsewhere on the board
/CM_UNIT_B/VBUS_EN: Module1.111 (VBUS_EN); also elsewhere on the board
/USB_BOOT/D+: Module1.105 (USB2_P); also elsewhere on the board
/USB_BOOT/D-: Module1.103 (USB2_N); also elsewhere on the board
GND: Module1.107 (GND), Module1.108 (GND), Module1.113 (GND), Module1.114 (GND), Module1.119 (GND), Module1.120 (GND), Module1.125 (GND), Module1.126 (GND), Module1.131 (GND), Module1.132 (GND), Module1.137 (GND), Module1.138 (GND), Module1.144 (GND), Module1.150 (GND), Module1.155 (GND), Module1.156 (GND), Module1.161 (GND), Module1.162 (GND), Module1.167 (GND), Module1.168 (GND), Module1.173 (GND), Module1.174 (GND), Module1.179 (GND), Module1.180 (GND), Module1.185 (GND), Module1.186 (GND), Module1.191 (GND), Module1.192 (GND), Module1.197 (GND), Module1.198 (GND), U10.2, U11.2, U12.2; also elsewhere on the board

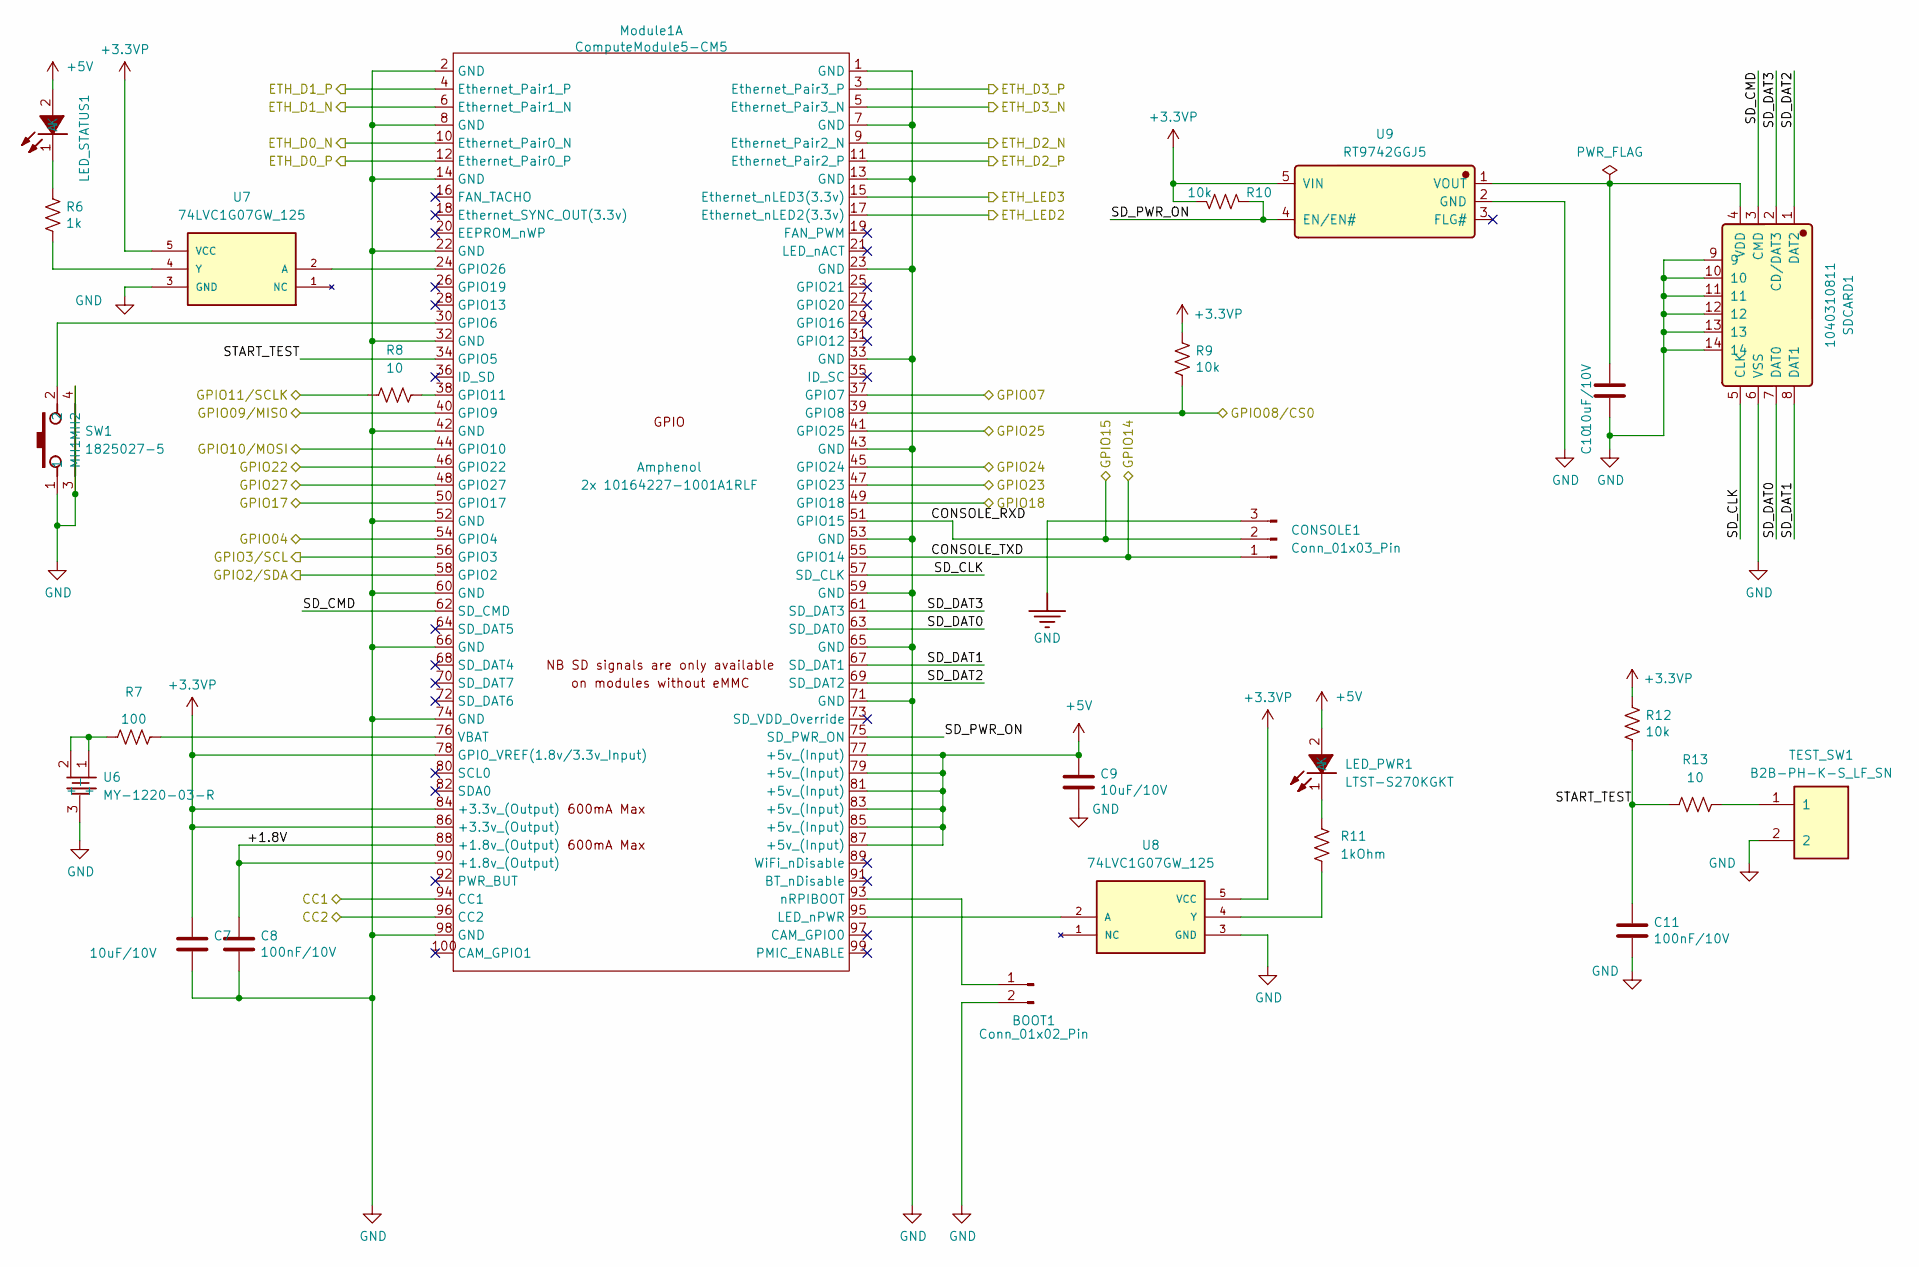
[picture p14: schematic CM_Unit_A.kicad_sch]

Parts:
BOOT1: Conn_01x02_Pin; PinHeader_1x02_P2.54mm_Vertical
C7, C9, C10: 10uF/10V; C_0603_1608Metric_Pad1.08x0.95mm_HandSolder
C8: 100nF/10V; C_0603_1608Metric_Pad1.08x0.95mm_HandSolder; Part Description 0.1uF 10% 16V Ceramic Capacitor X7R 040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
C11: 100nF/10V; C_0603_1608Metric; Part Description 0.1uF 10% 16V Ceramic Capacitor X7R 040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
CONSOLE1: Conn_01x03_Pin; PinHeader_1x03_P2.54mm_Vertical
LED_PWR1: LTST-S270KGKT; Manufacturer Part LTST-S270KGKT; LCSC C125113
LED_STATUS1: LTST-S270KRKT; Manufacturer Part LTST-S270KRKT; LCSC C125114
Module1: ComputeModule5-CM5; Raspberry-Pi-5-Compute-Module; Part Description 100 Position Connector Receptacle, Cent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
R6: 1k; R_0603_1608Metric; Part Description Resistor 1K M1005 1% 63mW
R7: 100; R_0603_1608Metric
R8, R13: 10; R_0603_1608Metric
R9: 10k; R_0603_1608Metric_Pad0.98x0.95mm_HandSolder; Part Description Resistor 1K M1005 1% 63mW
R10: 10k; R_0603_1608Metric
R11: 1kOhm; R_0603_1608Metric
R12: 10k; R_0603_1608Metric; Part Description Resistor 1K M1005 1% 63mW
SDCARD1: 1040310811; Manufacturer Part 1040310811; LCSC C585350
SW1: 1825027-5; Manufacturer Part 1825027-5; LCSC C86476
TEST_SW1: B2B-PH-K-S_LF_SN; Manufacturer Part B2B-PH-K-S(LF)(SN); LCSC C131337
U6: MY-1220-03-R; Manufacturer Part MY-1220-03-R; LCSC C964819
U7, U8: 74LVC1G07GW_125; IC_74LVC1G07GW_125; PARTREV 16
U9: RT9742GGJ5; Manufacturer Part RT9742GGJ5; LCSC C250547

Connections:
+3.3VP: C7.1, Module1.78 (GPIO_VREF(1.8v/3.3v_Input)), Module1.84 (+3.3v_(Output)), Module1.86 (+3.3v_(Output)), R9.1, R10.1, R12.1, U7.5 (VCC), U8.5 (VCC), U9.5 (VIN); also elsewhere on the board
+5V: C9.1, LED_PWR1.2 (A), LED_STATUS1.2 (A), Module1.77 (+5v_(Input)), Module1.79 (+5v_(Input)), Module1.81 (+5v_(Input)), Module1.83 (+5v_(Input)), Module1.85 (+5v_(Input)), Module1.87 (+5v_(Input)); also elsewhere on the board
/CM_UNIT_A/+1.8V: C8.1, Module1.88 (+1.8v_(Output)), Module1.90 (+1.8v_(Output))
/CM_UNIT_A/CC1: Module1.94 (CC1); also elsewhere on the board
/CM_UNIT_A/CC2: Module1.96 (CC2); also elsewhere on the board
/CM_UNIT_A/CONSOLE_RXD: CONSOLE1.2, Module1.51 (GPIO15); also elsewhere on the board
/CM_UNIT_A/CONSOLE_TXD: CONSOLE1.1, Module1.55 (GPIO14); also elsewhere on the board
/CM_UNIT_A/ETH_LED2: Module1.17 (Ethernet_nLED2(3.3v)); also elsewhere on the board
/CM_UNIT_A/ETH_LED3: Module1.15 (Ethernet_nLED3(3.3v)); also elsewhere on the board
/CM_UNIT_A/GPIO2/SDA: Module1.58 (GPIO2); also elsewhere on the board
/CM_UNIT_A/GPIO3/SCL: Module1.56 (GPIO3); also elsewhere on the board
/CM_UNIT_A/GPIO04: Module1.54 (GPIO4); also elsewhere on the board
/CM_UNIT_A/GPIO07: Module1.37 (GPIO7); also elsewhere on the board
/CM_UNIT_A/GPIO08/CS0: Module1.39 (GPIO8), R9.2; also elsewhere on the board
/CM_UNIT_A/GPIO09/MISO: Module1.40 (GPIO9); also elsewhere on the board
/CM_UNIT_A/GPIO10/MOSI: Module1.44 (GPIO10); also elsewhere on the board
/CM_UNIT_A/GPIO11/SCLK: R8.1; also elsewhere on the board
/CM_UNIT_A/GPIO17: Module1.50 (GPIO17); also elsewhere on the board
/CM_UNIT_A/GPIO18: Module1.49 (GPIO18); also elsewhere on the board
/CM_UNIT_A/GPIO22: Module1.46 (GPIO22); also elsewhere on the board
/CM_UNIT_A/GPIO23: Module1.47 (GPIO23); also elsewhere on the board
/CM_UNIT_A/GPIO24: Module1.45 (GPIO24); also elsewhere on the board
/CM_UNIT_A/GPIO25: Module1.41 (GPIO25); also elsewhere on the board
/CM_UNIT_A/GPIO27: Module1.48 (GPIO27); also elsewhere on the board
/CM_UNIT_A/SD_CLK: Module1.57 (SD_CLK), SDCARD1.5 (CLK)
/CM_UNIT_A/SD_CMD: Module1.62 (SD_CMD), SDCARD1.3 (CMD)
/CM_UNIT_A/SD_DAT0: Module1.63 (SD_DAT0), SDCARD1.7 (DAT0)
/CM_UNIT_A/SD_DAT1: Module1.67 (SD_DAT1), SDCARD1.8 (DAT1)
/CM_UNIT_A/SD_DAT2: Module1.69 (SD_DAT2), SDCARD1.1 (DAT2)
/CM_UNIT_A/SD_DAT3: Module1.61 (SD_DAT3), SDCARD1.2 (CD/DAT3)
/CM_UNIT_A/SD_PWR_ON: Module1.75 (SD_PWR_ON), R10.2, U9.4 (EN/EN#)
/CM_UNIT_A/START_TEST: C11.1, Module1.34 (GPIO5), R12.2, R13.1
/ETHERNET/TRD0_N: Module1.10 (Ethernet_Pair0_N); also elsewhere on the board
/ETHERNET/TRD0_P: Module1.12 (Ethernet_Pair0_P); also elsewhere on the board
/ETHERNET/TRD1_N: Module1.6 (Ethernet_Pair1_N); also elsewhere on the board
/ETHERNET/TRD1_P: Module1.4 (Ethernet_Pair1_P); also elsewhere on the board
/ETHERNET/TRD2_N: Module1.9 (Ethernet_Pair2_N); also elsewhere on the board
/ETHERNET/TRD2_P: Module1.11 (Ethernet_Pair2_P); also elsewhere on the board
/ETHERNET/TRD3_N: Module1.5 (Ethernet_Pair3_N); also elsewhere on the board
/ETHERNET/TRD3_P: Module1.3 (Ethernet_Pair3_P); also elsewhere on the board
GND: BOOT1.2, C7.2, C8.2, C9.2, C10.2, C11.2, CONSOLE1.3, Module1.1 (GND), Module1.2 (GND), Module1.7 (GND), Module1.8 (GND), Module1.13 (GND), Module1.14 (GND), Module1.22 (GND), Module1.23 (GND), Module1.32 (GND), Module1.33 (GND), Module1.42 (GND), Module1.43 (GND), Module1.52 (GND), Module1.53 (GND), Module1.59 (GND), Module1.60 (GND), Module1.65 (GND), Module1.66 (GND), Module1.71 (GND), Module1.74 (GND), Module1.98 (GND), SDCARD1.6 (VSS), SDCARD1.9, SDCARD1.10, SDCARD1.11, SDCARD1.12, SDCARD1.13, SDCARD1.14, SW1.1, SW1.3 (MH1), SW1.4 (MH2), TEST_SW1.2, U6.3 (-), U7.3 (GND), U8.3 (GND), U9.2 (GND); also elsewhere on the board
unnamed: BOOT1.1, Module1.93 (nRPIBOOT)
unnamed: LED_PWR1.1 (K), R11.1
unnamed: LED_STATUS1.1 (K), R6.1
unnamed: Module1.30 (GPIO6), SW1.2
unnamed: Module1.38 (GPIO11), R8.2
unnamed: Module1.24 (GPIO26), U7.2 (A)
unnamed: Module1.95 (LED_nPWR), U8.2 (A)
unnamed: Module1.76 (VBAT), R7.2
unnamed: R7.1, U6.1 (+), U6.2 (+)
unnamed: R13.2, TEST_SW1.1
unnamed: C10.1, SDCARD1.4 (VDD), U9.1 (VOUT)
unnamed: R6.2, U7.4 (Y)
unnamed: R11.2, U8.4 (Y)

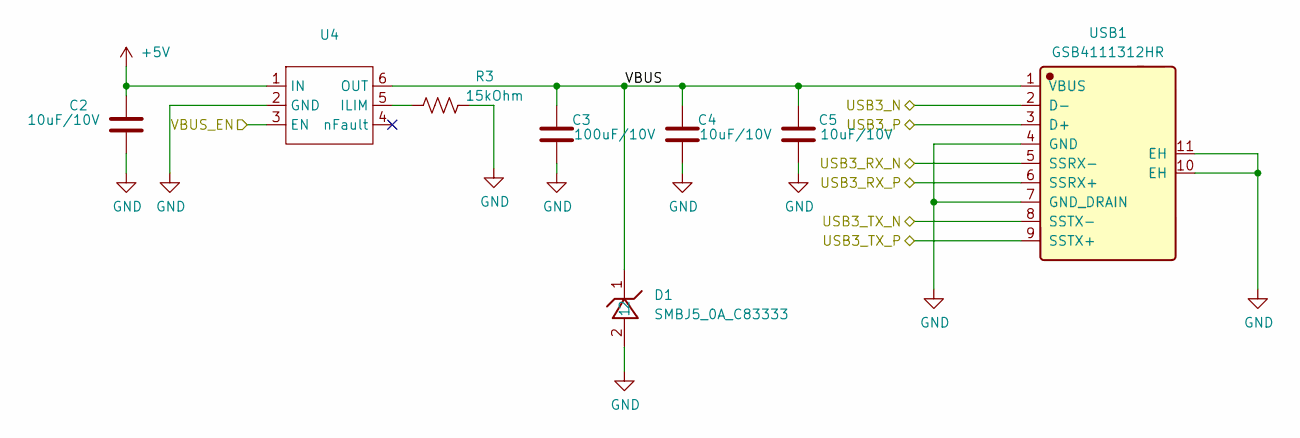
[picture p15: schematic USB3.0.kicad_sch]

Parts:
C2, C4, C5: 10uF/10V; C_0603_1608Metric; Manufacturer_Part_Number GRM21BR61H106KE43L
C3: 100uF/10V; C_1210_3225Metric; Manufacturer_Part_Number GRM21BR61H106KE43L
D1: SMBJ5_0A_C83333; Manufacturer Part SMBJ5.0A; LCSC C83333
R3: 15kOhm; R_0603_1608Metric
U4: AP22653W6-7; SOT-23-6; Part Description Power Switch/Driver 1:1 P-Channel 2.1A 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
USB1: GSB4111312HR; Manufacturer Part GSB4111312HR; LCSC C5429382

Connections:
+5V: C2.1, U4.1 (IN); also elsewhere on the board
/CM_UNIT_B/USB3_N: USB1.2 (D-); also elsewhere on the board
/CM_UNIT_B/USB3_P: USB1.3 (D+); also elsewhere on the board
/CM_UNIT_B/USB3_RX_N: USB1.5 (SSRX-); also elsewhere on the board
/CM_UNIT_B/USB3_RX_P: USB1.6 (SSRX+); also elsewhere on the board
/CM_UNIT_B/USB3_TX_N: USB1.8 (SSTX-); also elsewhere on the board
/CM_UNIT_B/USB3_TX_P: USB1.9 (SSTX+); also elsewhere on the board
/CM_UNIT_B/VBUS_EN: U4.3 (EN); also elsewhere on the board
/USB3.0/VBUS: C3.1, C4.1, C5.1, D1.1, U4.6 (OUT), USB1.1 (VBUS)
GND: C2.2, C3.2, C4.2, C5.2, D1.2, R3.2, U4.2 (GND), USB1.4 (GND), USB1.7 (GND_DRAIN), USB1.10 (EH), USB1.11 (EH); also elsewhere on the board
unnamed: R3.1, U4.5 (ILIM)

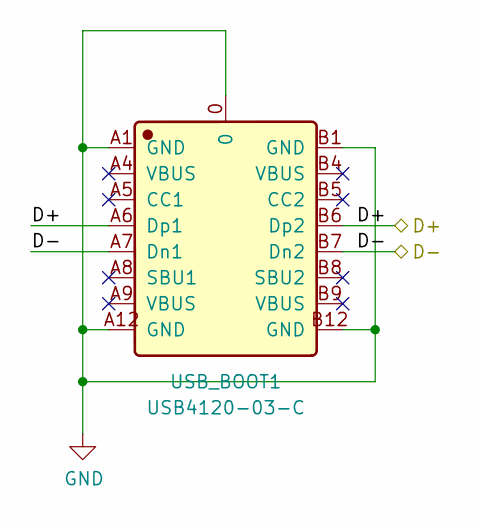
[picture p16: schematic untitled.kicad_sch]

Parts:
USB_BOOT1: USB4120-03-C; Manufacturer Part USB4120-03-C; LCSC C3445864

Connections:
/USB_BOOT/D+: USB_BOOT1.A6 (Dp1), USB_BOOT1.B6 (Dp2); also elsewhere on the board
/USB_BOOT/D-: USB_BOOT1.A7 (Dn1), USB_BOOT1.B7 (Dn2); also elsewhere on the board
GND: USB_BOOT1.0, USB_BOOT1.A1 (GND), USB_BOOT1.A12 (GND), USB_BOOT1.B1 (GND), USB_BOOT1.B12 (GND); also elsewhere on the board

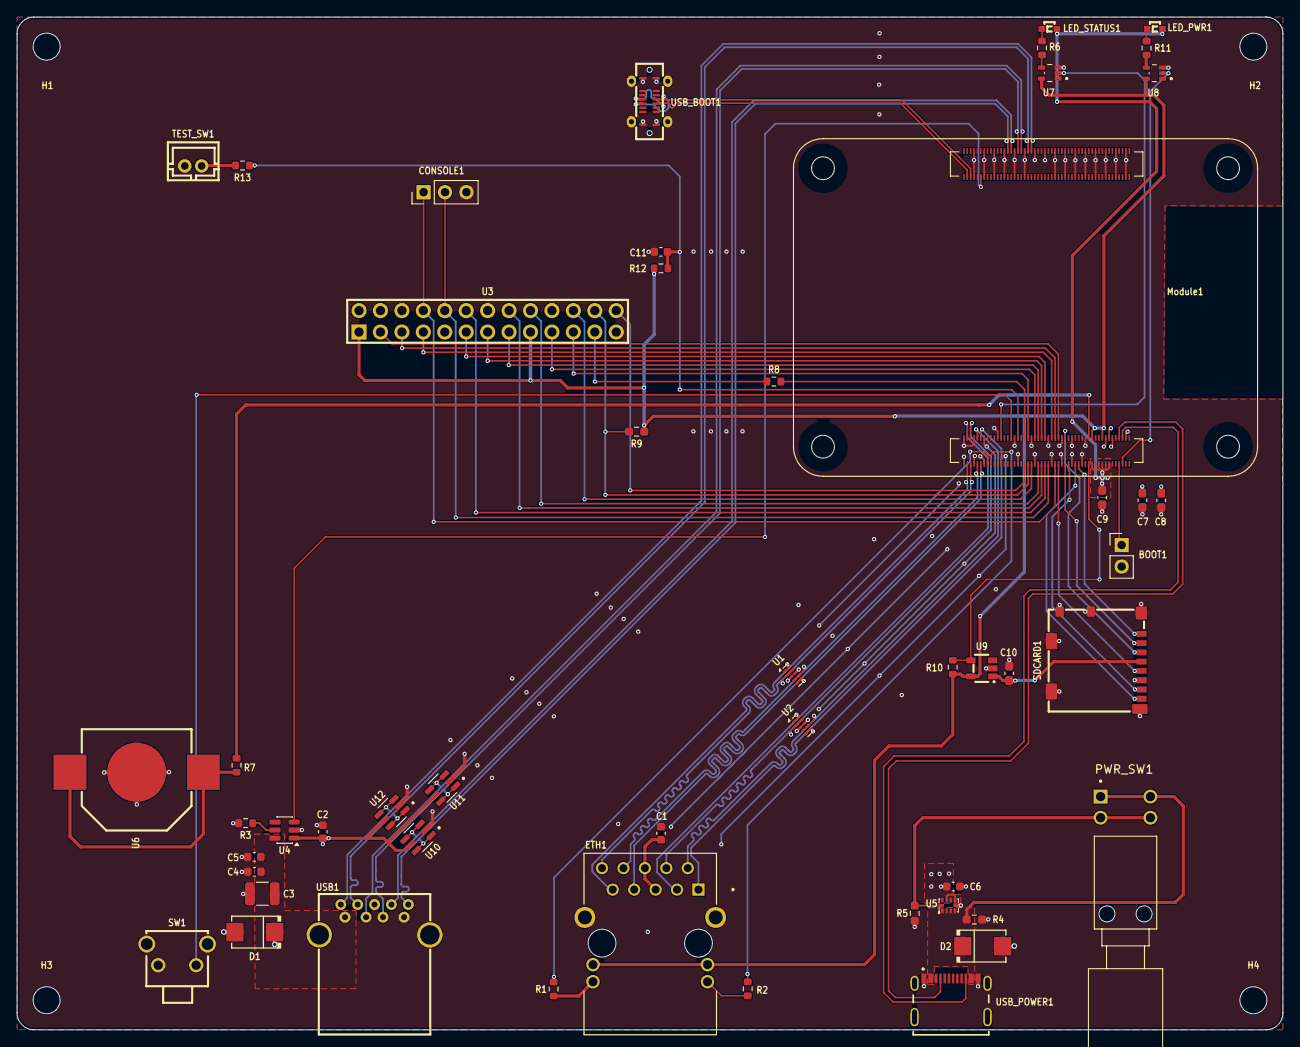
[picture p17: board Network Analyzer.kicad_pcb from above]

Board: 4 copper layers, 150.0 x 120.0 mm, 55 parts (0 on the bottom side), 70 nets.
